reinerdizonparadis/Police_Lights_and_Sirens/README.md

# Police Lights & Siren - Circuits II Lab Final Project

UNLV College of Engineering - Department of Electrical & Computer Engineering<br>
**Class**: EE 221L<br>
**Team Members**: Reiner Dizon & Ryan Dunlap<br>

All schematics are in its folders. Refer to Project Report PDF for more details.
