reinerdizonparadis/Police_Lights_and_Sirens/schematic/police light.asc

C1: cap; 2.2µ
D1: diode; 1N4148
D2: diode; 1N4148
D3: diode; 1N4148
D4: diode; 1N4148
D5: diode; 1N4148
D6: diode; 1N4148
D7: LED; NSCW100
D8: LED; NSCW100
D9: LED; NSCW100
D10: LED; NSCW100
Q1: npn2; BC547C
Q2: npn2; BC547C
R1: res; 22K
R2: res; 1K
R3: res; 470
R4: res; 470
R5: res; 470
R6: res; 470
R7: res; 470
R8: res; 470
R9: res; 470
R10: res; 470
U1: NE555
U2: CD4017B
V1: voltage; 9
Named nets: 0
.tran 5
