reinerdizonparadis/Police_Lights_and_Sirens/schematic/police siren.asc

C1: cap; 10µ
C2: cap; 10n
C3: cap; 100n
C4: cap; 100µ
D1: diode; 1N4001
R1: res; 68K
R2: res; 68K
R3: res; 8.2K
R4: res; 8.2K
R5: res; 10K
U1: NE555
U2: NE555
V1: voltage; 12
Named nets: 0, SpkrOut
.tran 5
